tanvirbinzahid/Smart-Flood-Early-Warning-System-STM32/Simulation_Data/figures/ablation_study.png

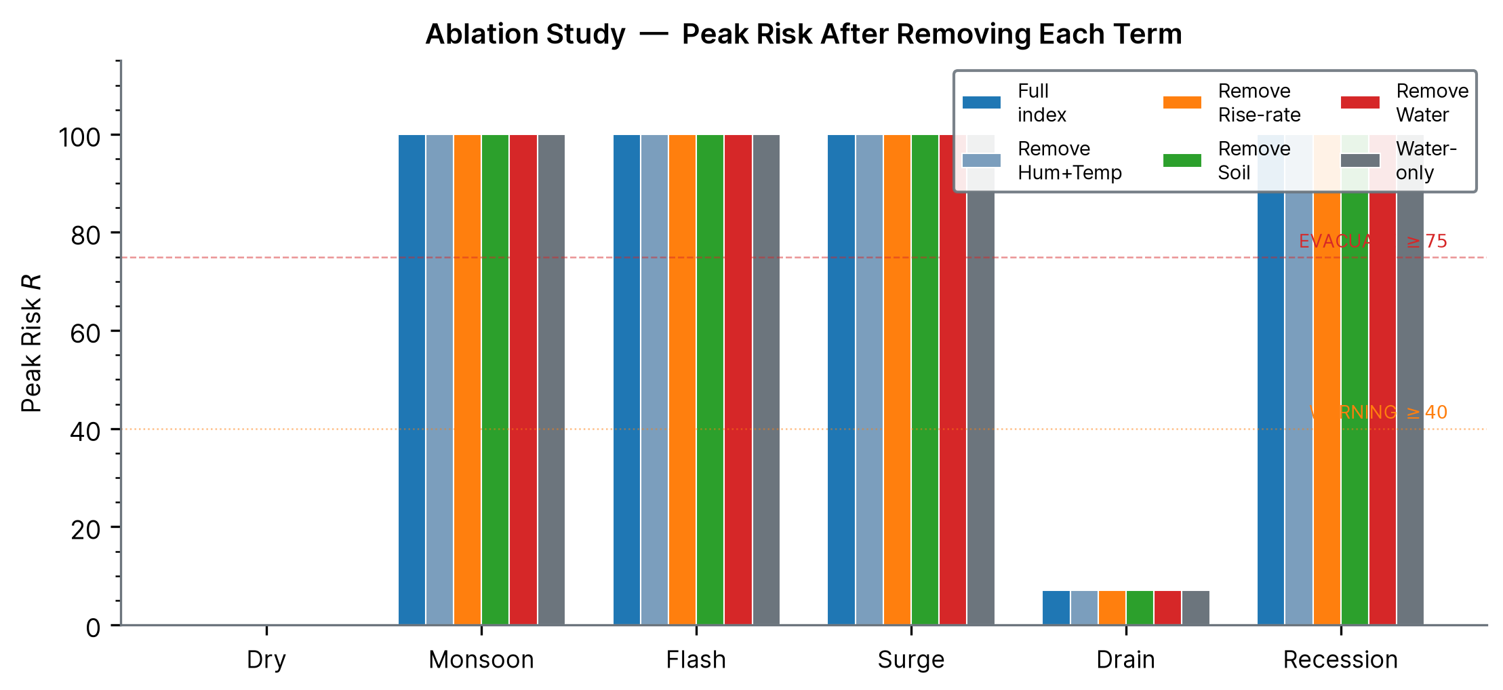
Simulation_Data/figures/ablation_study.png
