tanvirbinzahid/Smart-Flood-Early-Warning-System-STM32/Simulation_Data/figures/coastal_storm_surge.png

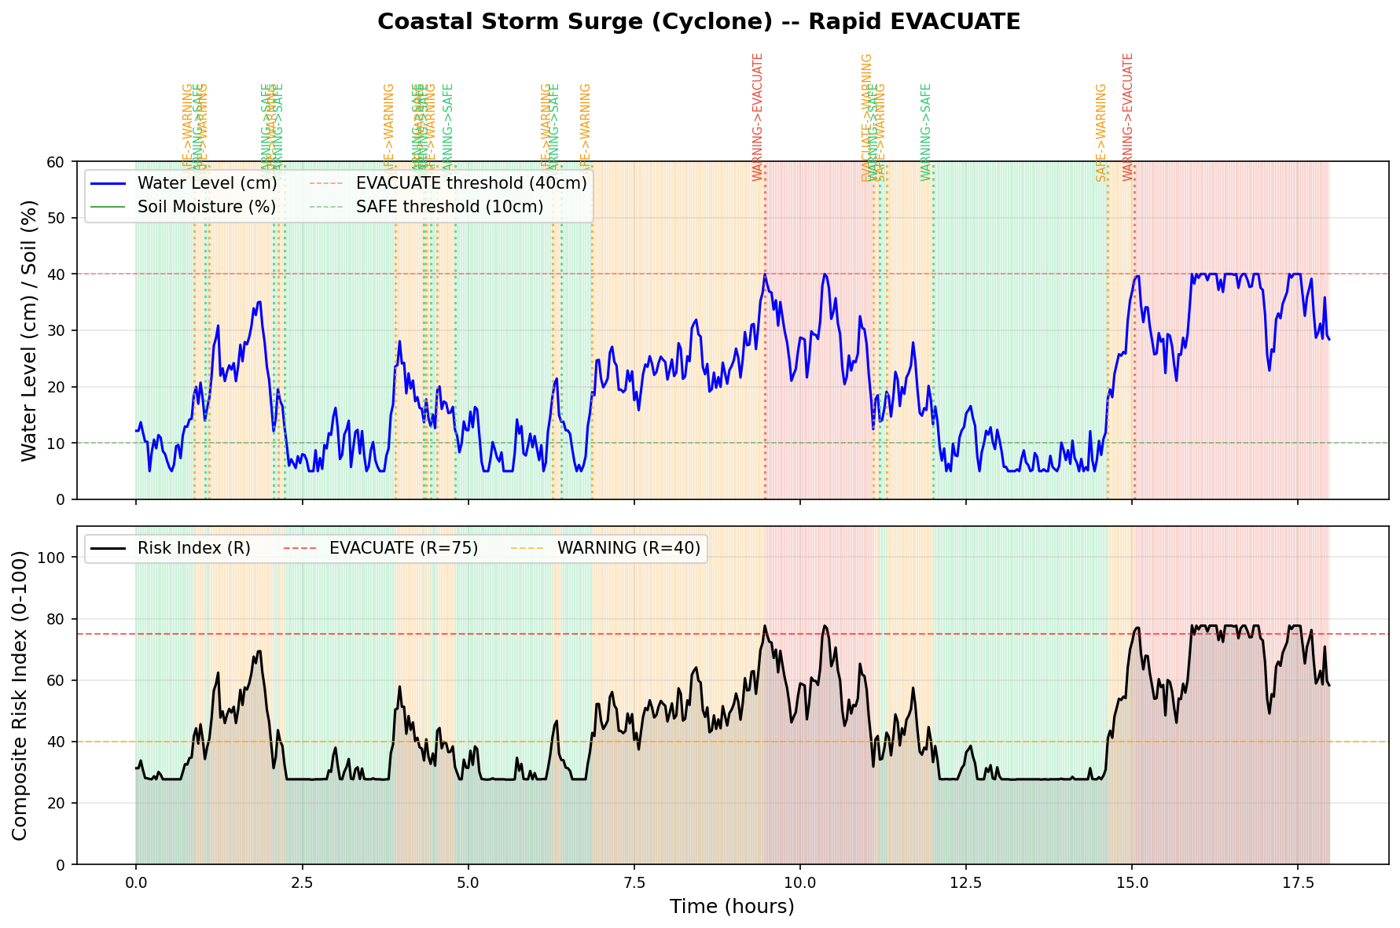
Simulation_Data/figures/coastal_storm_surge.png
