tanvirbinzahid/Smart-Flood-Early-Warning-System-STM32/Simulation_Data/figures/ffwc_buriganga_timeline.png

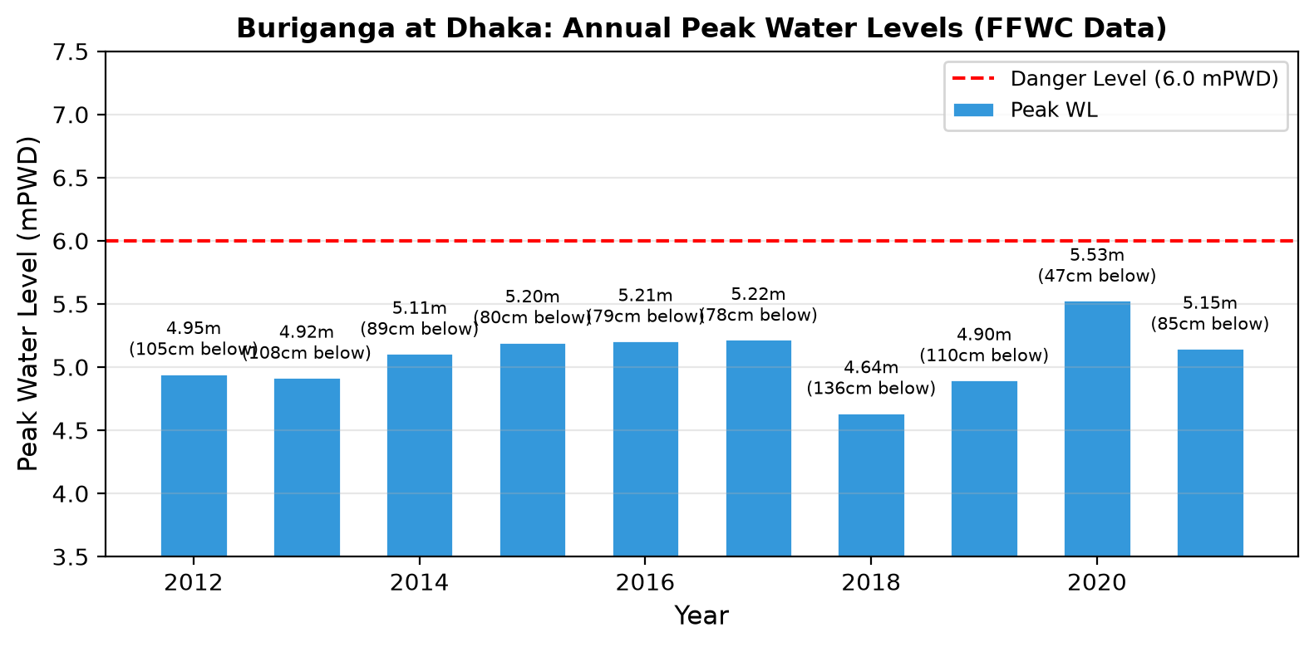
Simulation_Data/figures/ffwc_buriganga_timeline.png
