tanvirbinzahid/Smart-Flood-Early-Warning-System-STM32/Simulation_Data/figures/flash_flood.png

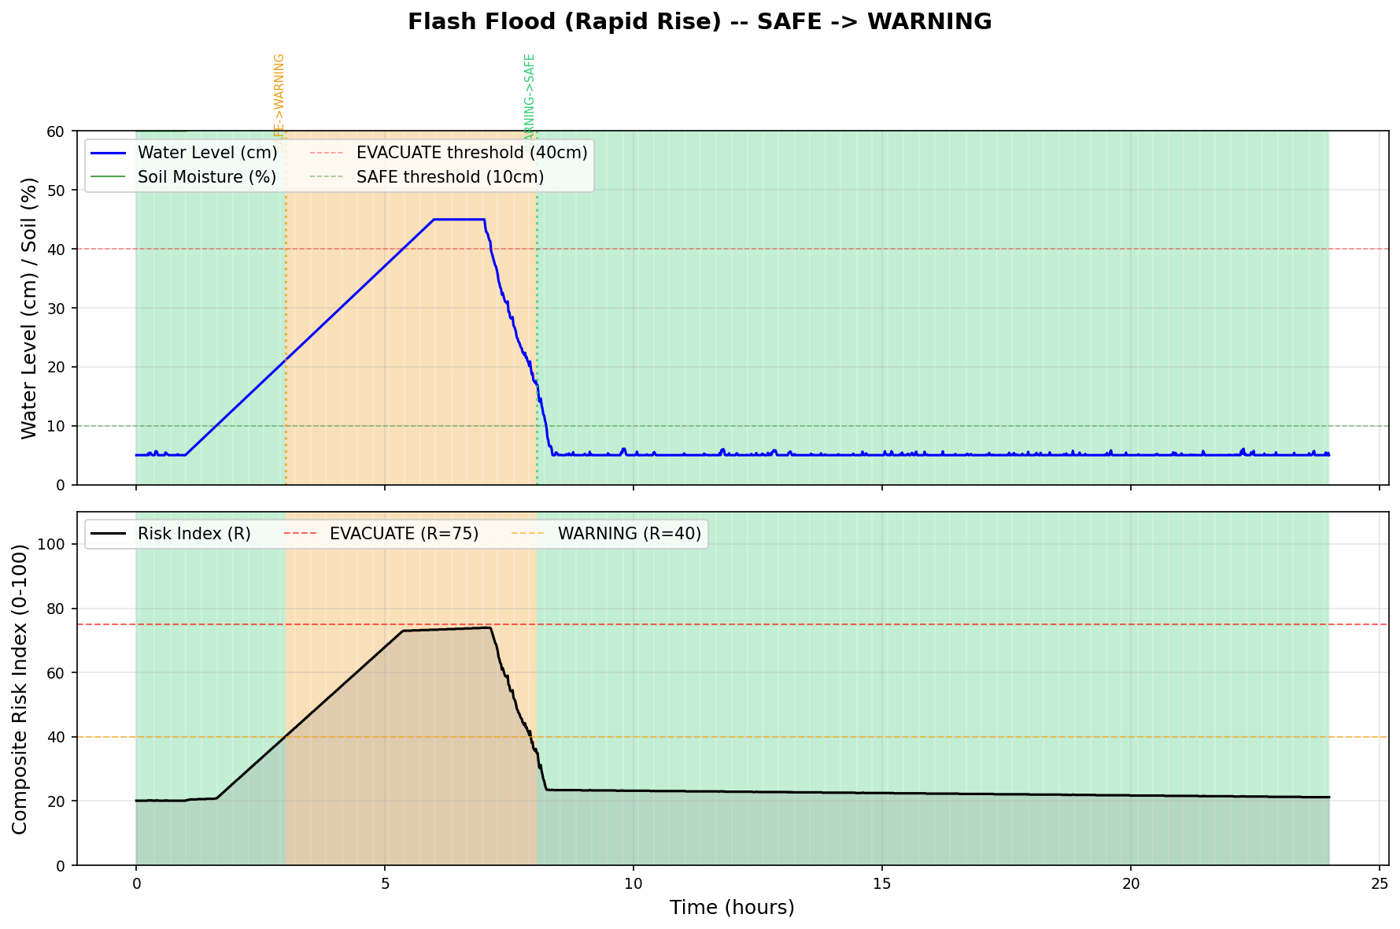
Simulation_Data/figures/flash_flood.png
