tanvirbinzahid/Smart-Flood-Early-Warning-System-STM32/Simulation_Data/figures/hw_accuracy_scatter.png

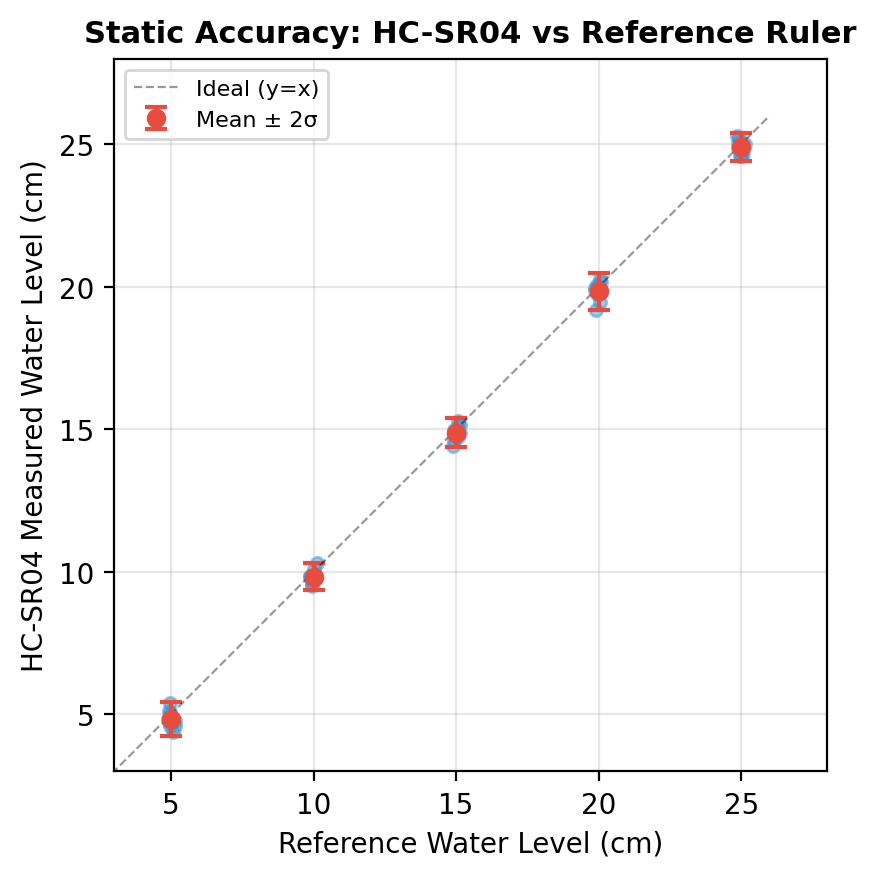
Simulation_Data/figures/hw_accuracy_scatter.png
