tanvirbinzahid/Smart-Flood-Early-Warning-System-STM32/Simulation_Data/figures/hw_bland_altman.png

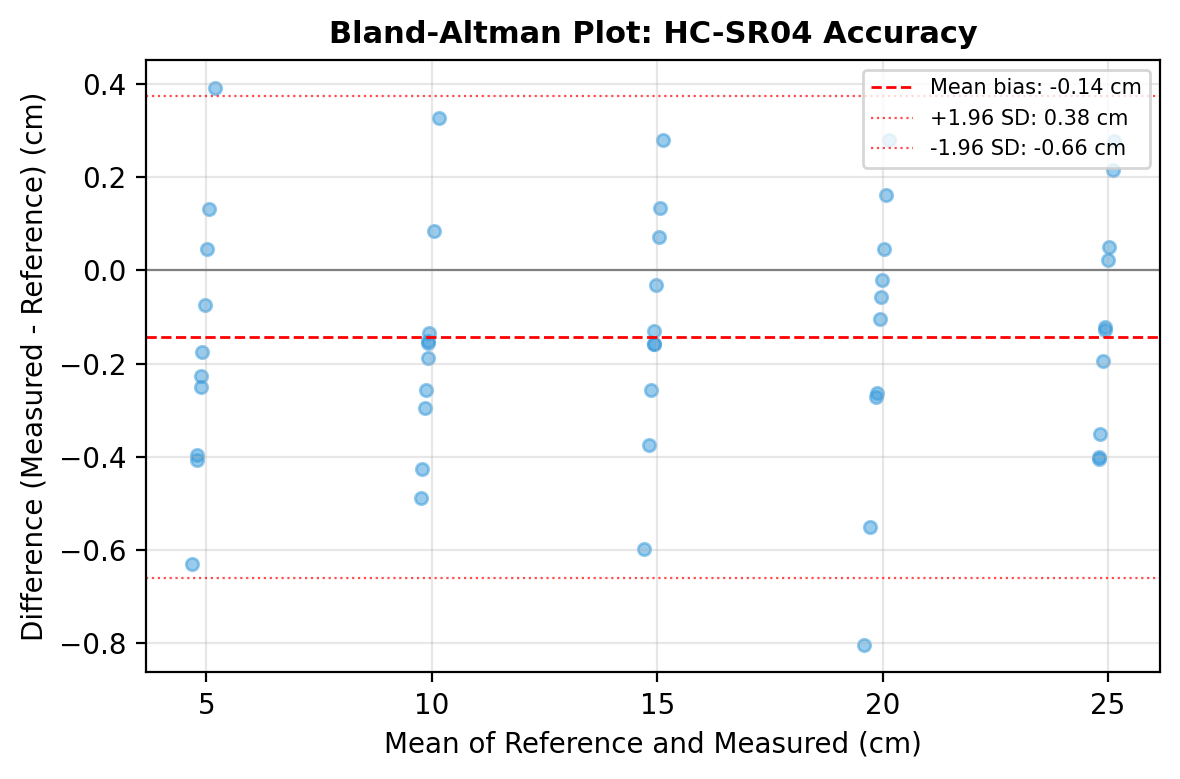
Simulation_Data/figures/hw_bland_altman.png
