tanvirbinzahid/Smart-Flood-Early-Warning-System-STM32/Simulation_Data/figures/monsoon_gradual.png

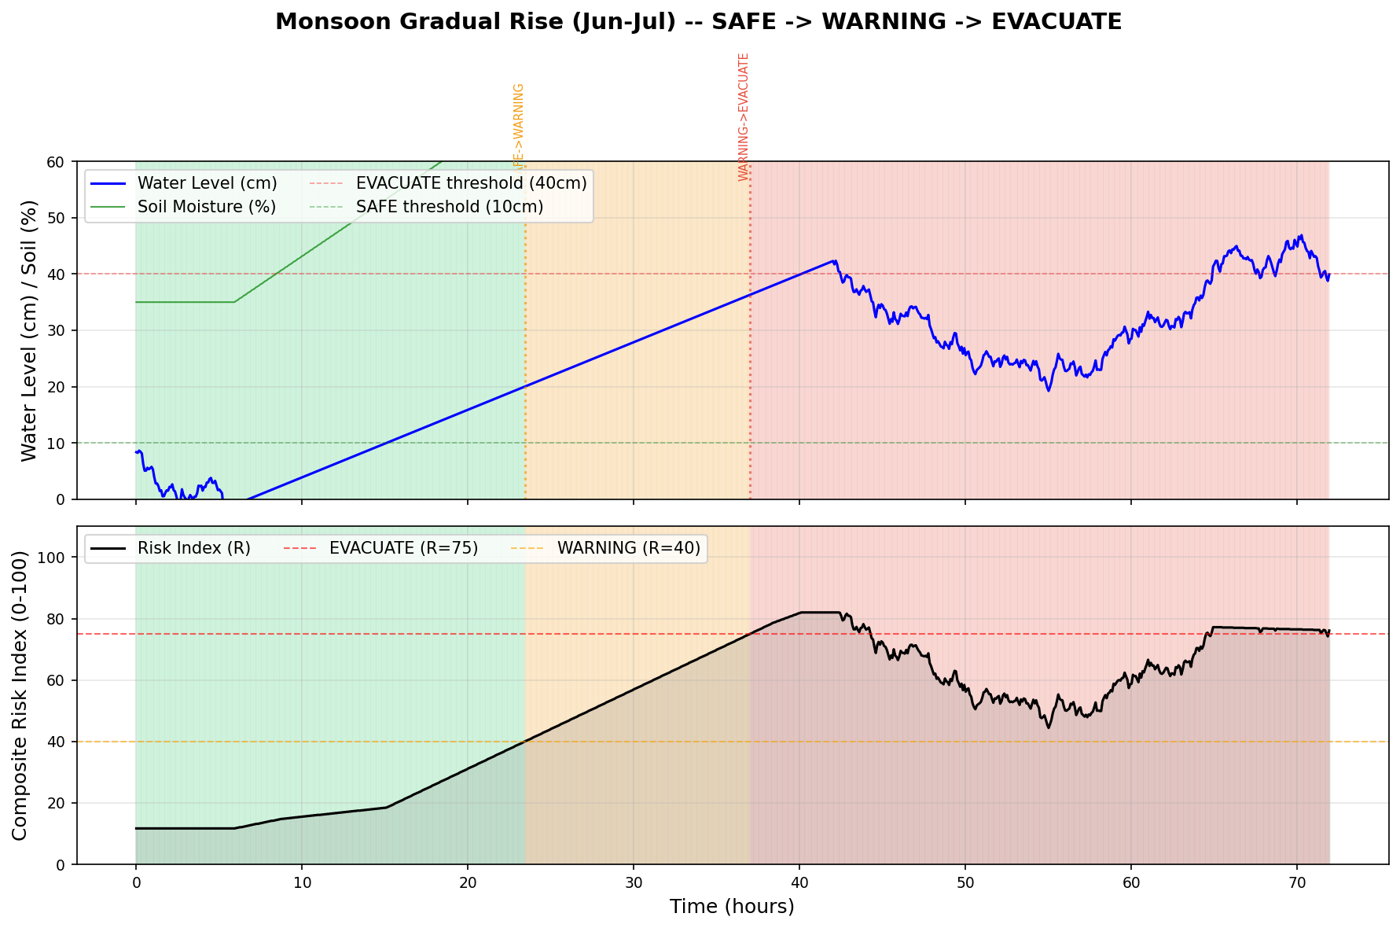
Simulation_Data/figures/monsoon_gradual.png
