tanvirbinzahid/Smart-Flood-Early-Warning-System-STM32/Simulation_Data/figures/normal_dry.png

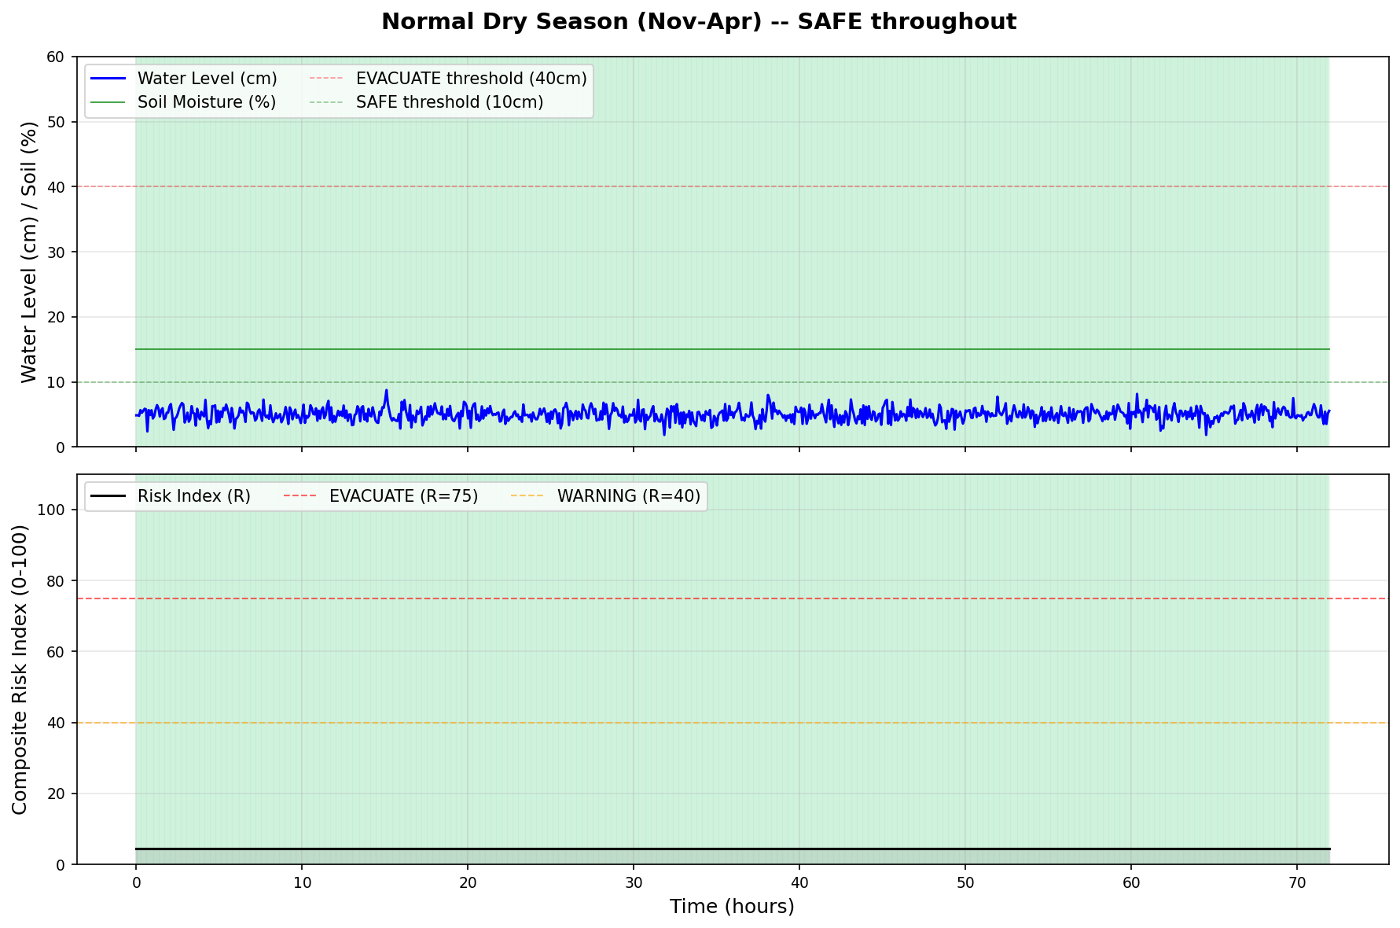
Simulation_Data/figures/normal_dry.png
