tanvirbinzahid/Smart-Flood-Early-Warning-System-STM32/Simulation_Data/figures/post_flood_recession.png

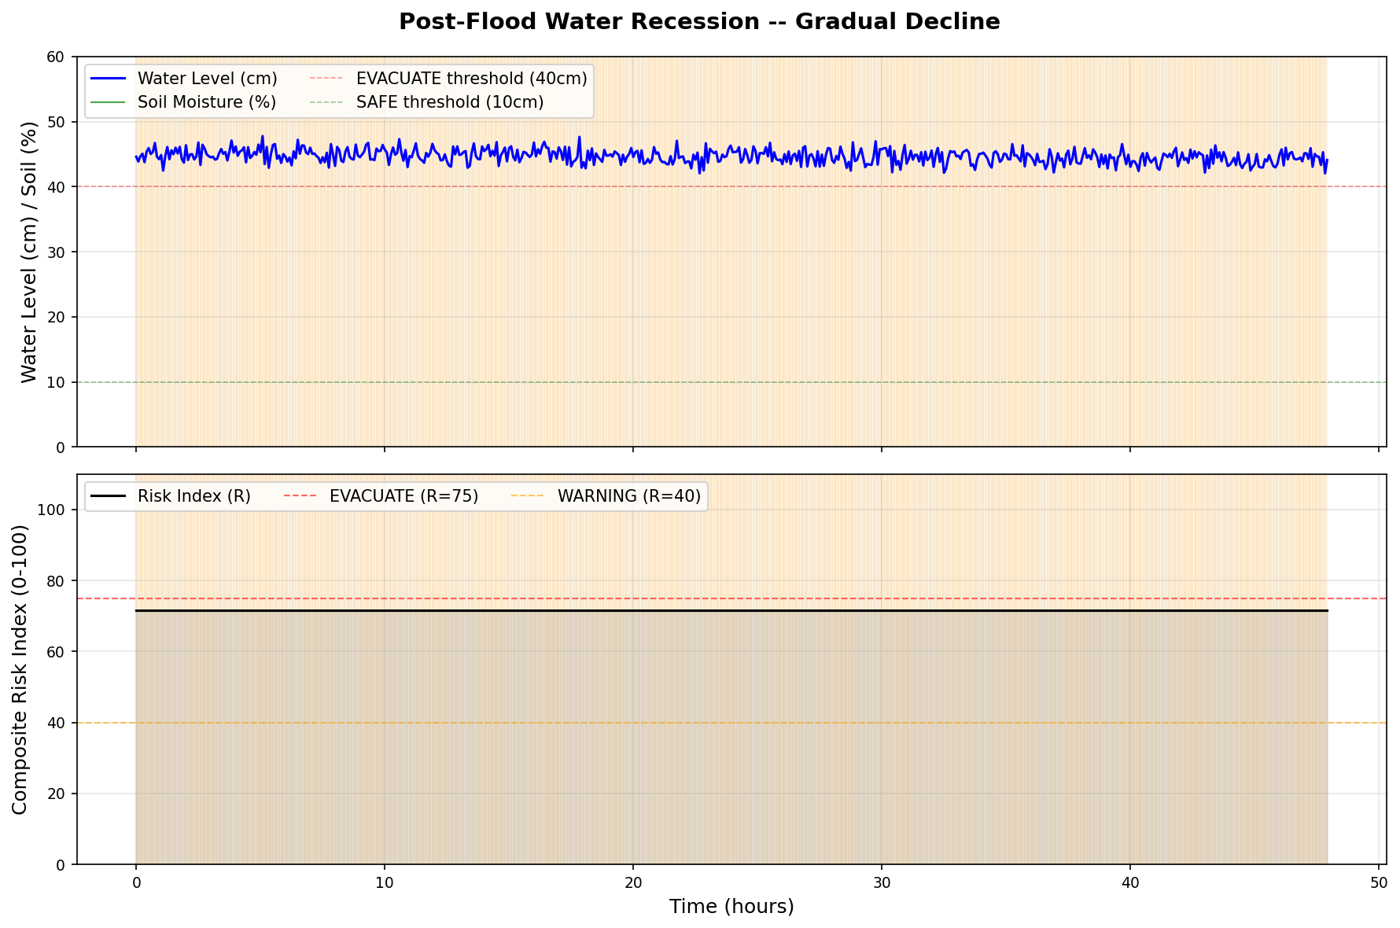
Simulation_Data/figures/post_flood_recession.png
