tanvirbinzahid/Smart-Flood-Early-Warning-System-STM32/Simulation_Data/figures/urban_drain_overload.png

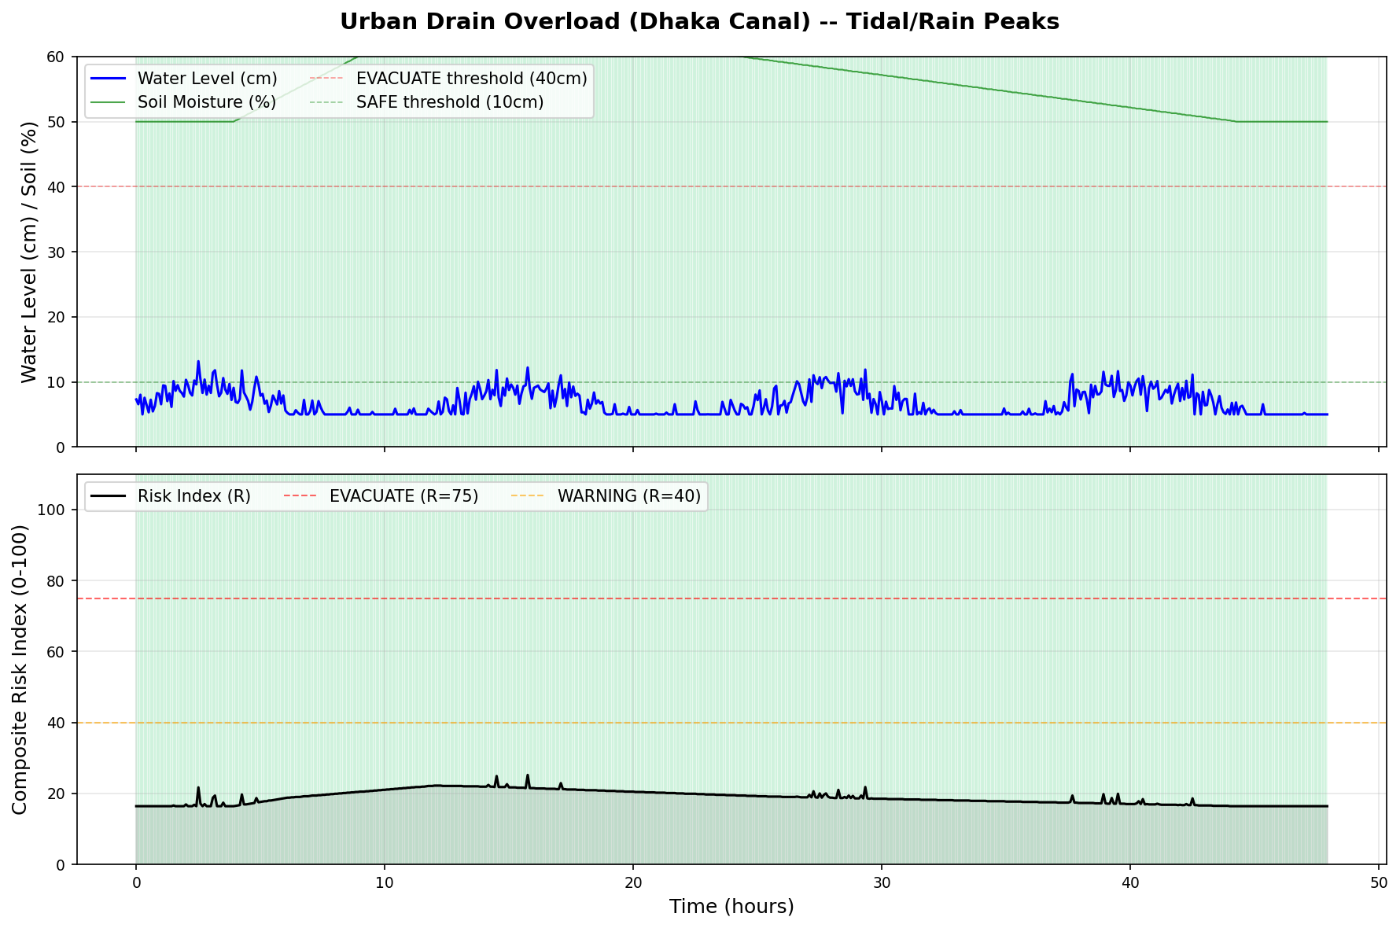
Simulation_Data/figures/urban_drain_overload.png
