tanvirbinzahid/Smart-Flood-Early-Warning-System-STM32/Simulation_Data/scripts/figures/all_scenarios_comparison.png

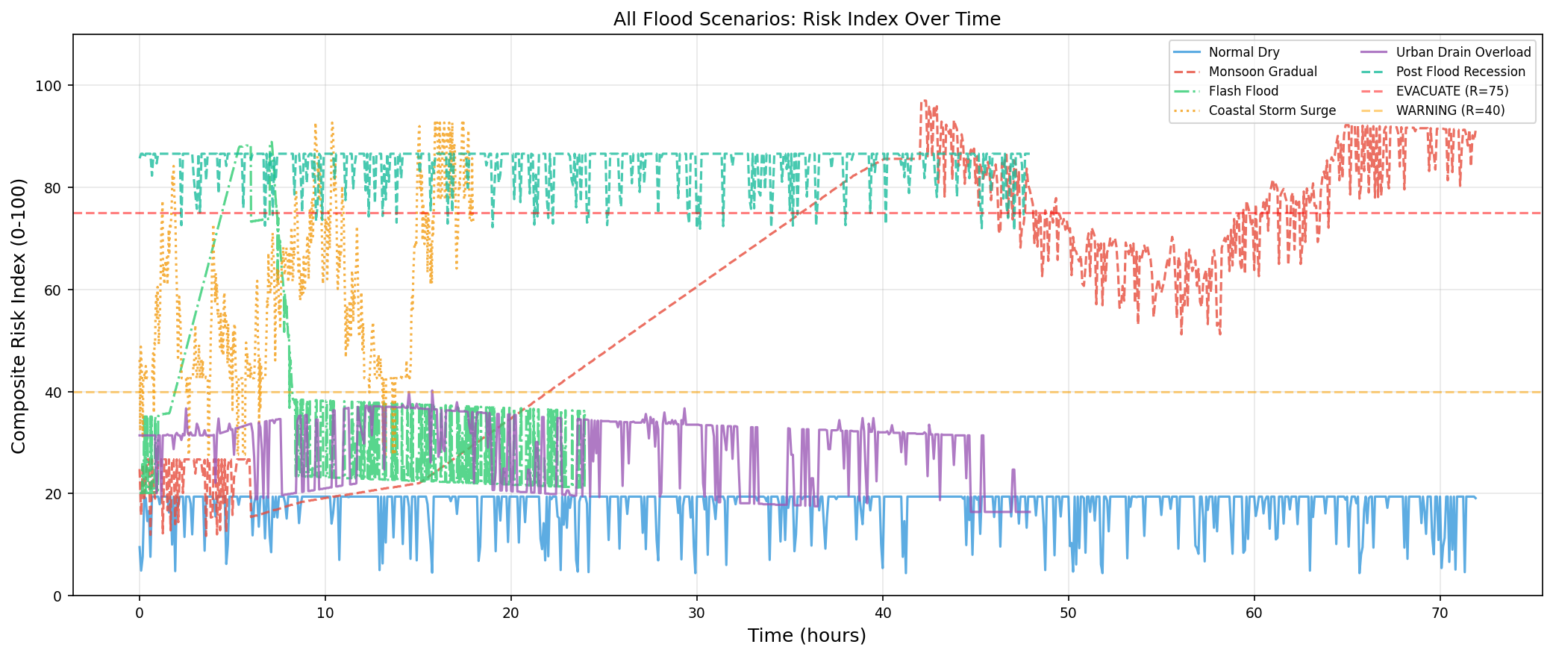
Simulation_Data/scripts/figures/all_scenarios_comparison.png
