tanvirbinzahid/Smart-Flood-Early-Warning-System-STM32/Simulation_Data/scripts/figures/coastal_storm_surge.png

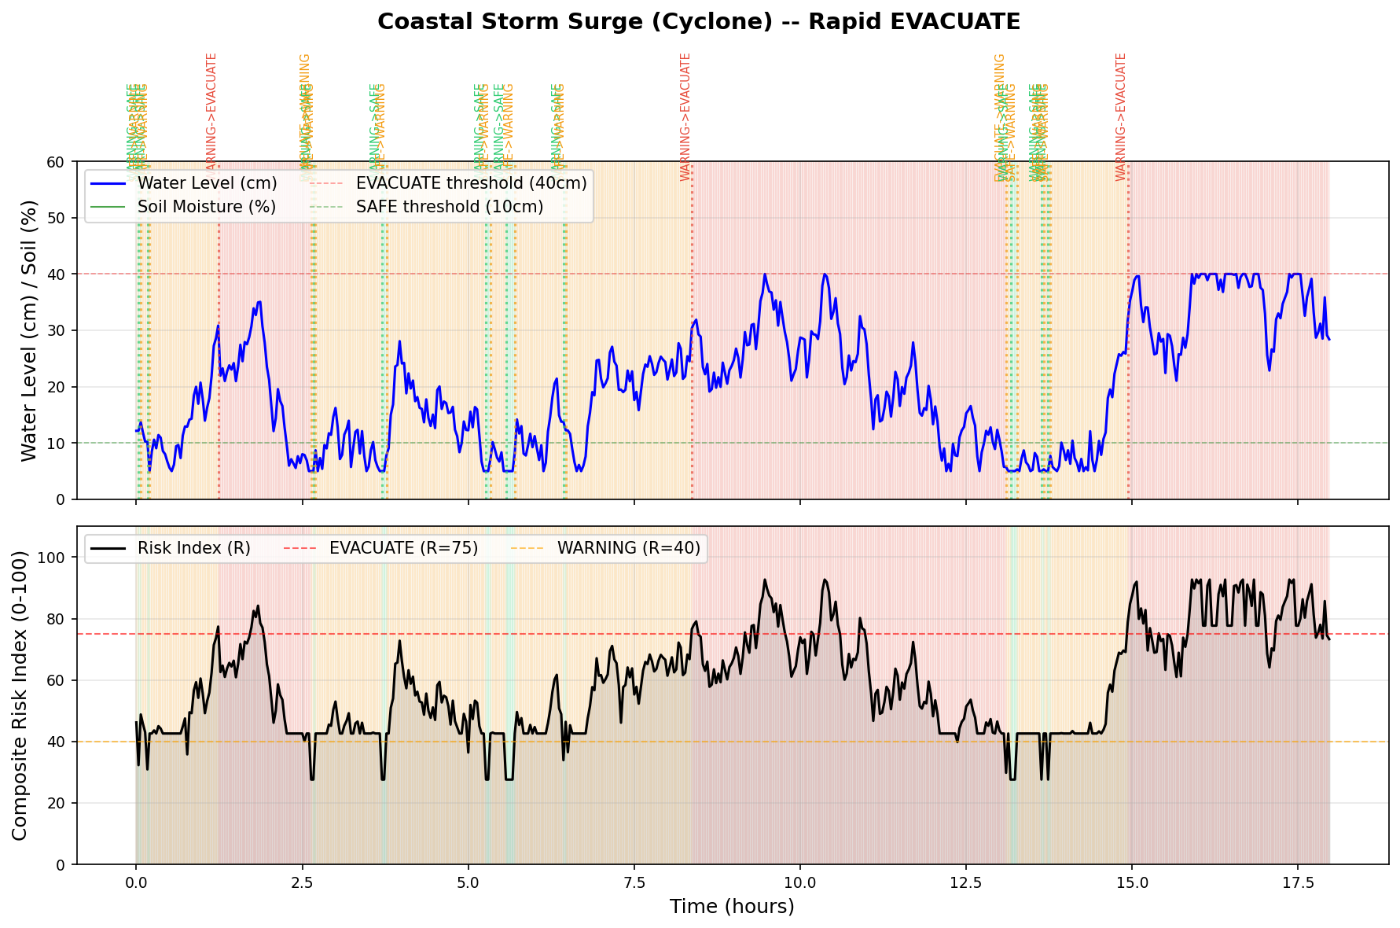
Simulation_Data/scripts/figures/coastal_storm_surge.png
