tanvirbinzahid/Smart-Flood-Early-Warning-System-STM32/Simulation_Data/scripts/figures/flash_flood.png

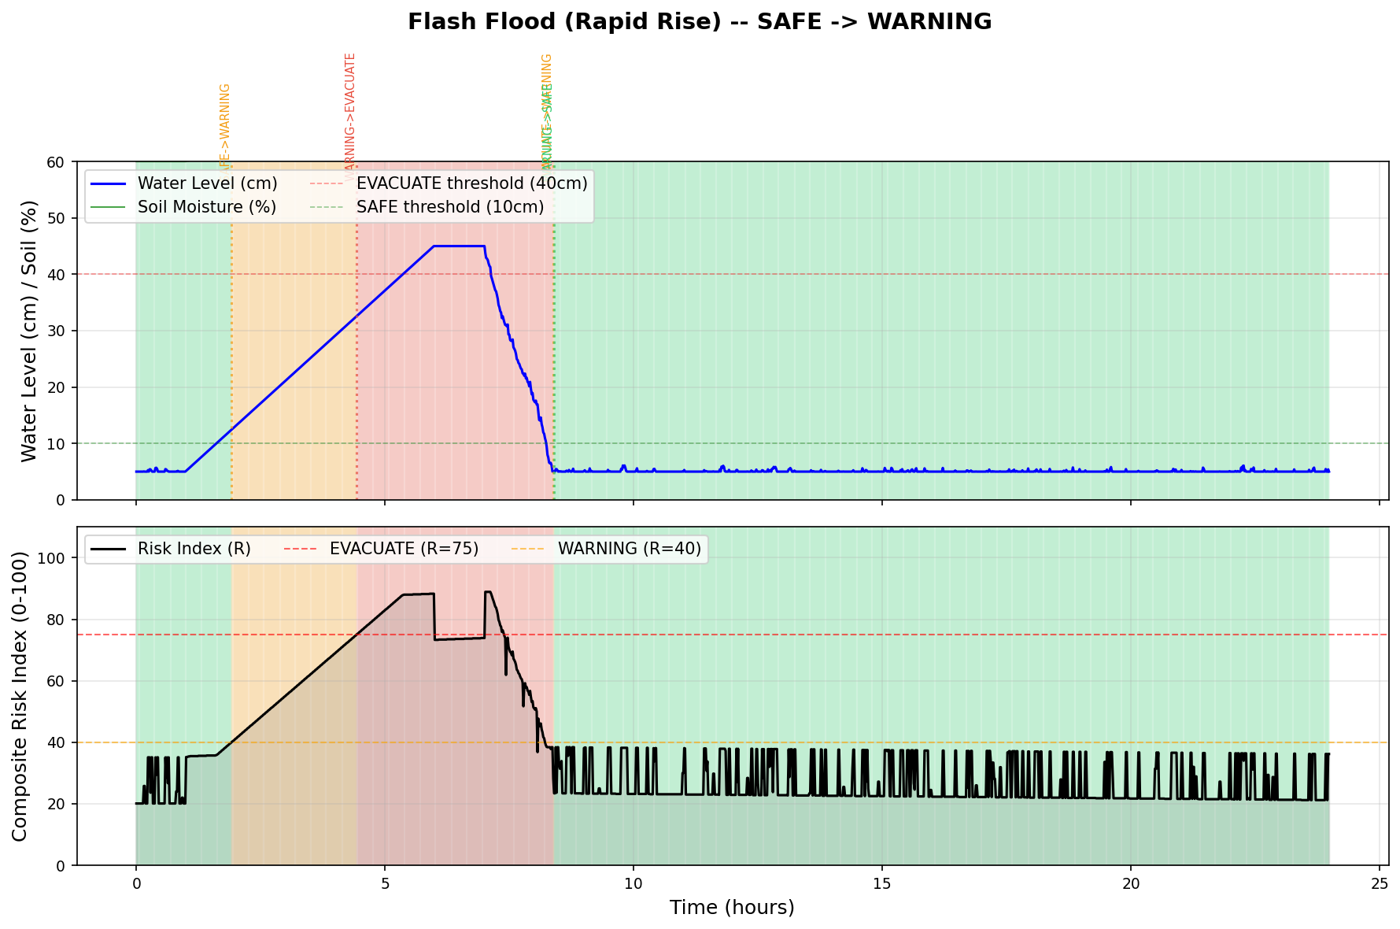
Simulation_Data/scripts/figures/flash_flood.png
