tanvirbinzahid/Smart-Flood-Early-Warning-System-STM32/Simulation_Data/scripts/figures/monsoon_gradual.png

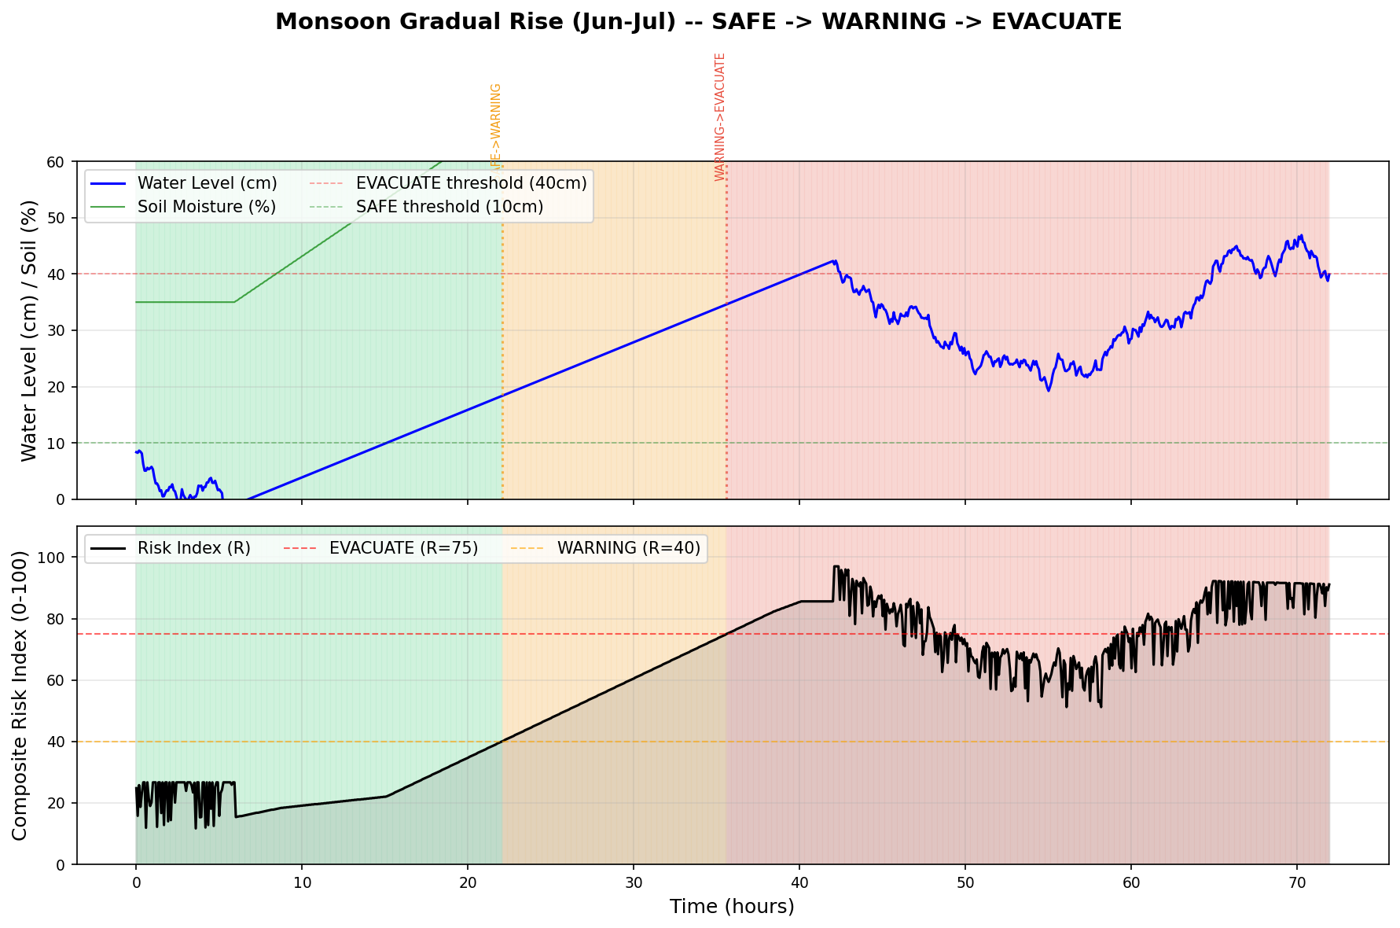
Simulation_Data/scripts/figures/monsoon_gradual.png
