tanvirbinzahid/Smart-Flood-Early-Warning-System-STM32/Simulation_Data/scripts/figures/normal_dry.png

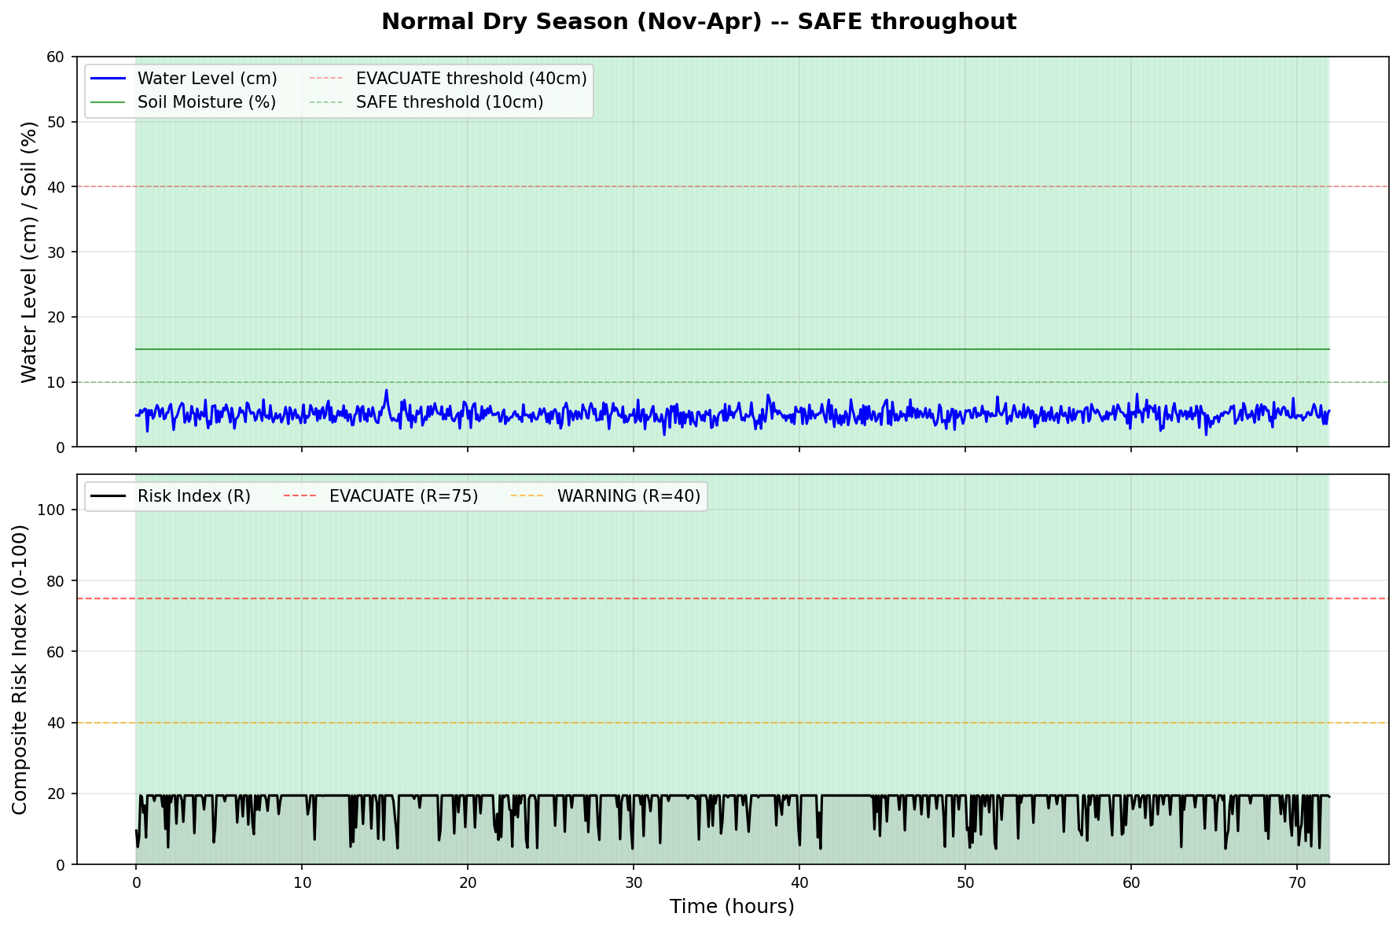
Simulation_Data/scripts/figures/normal_dry.png
