tanvirbinzahid/Smart-Flood-Early-Warning-System-STM32/Simulation_Data/scripts/figures/post_flood_recession.png

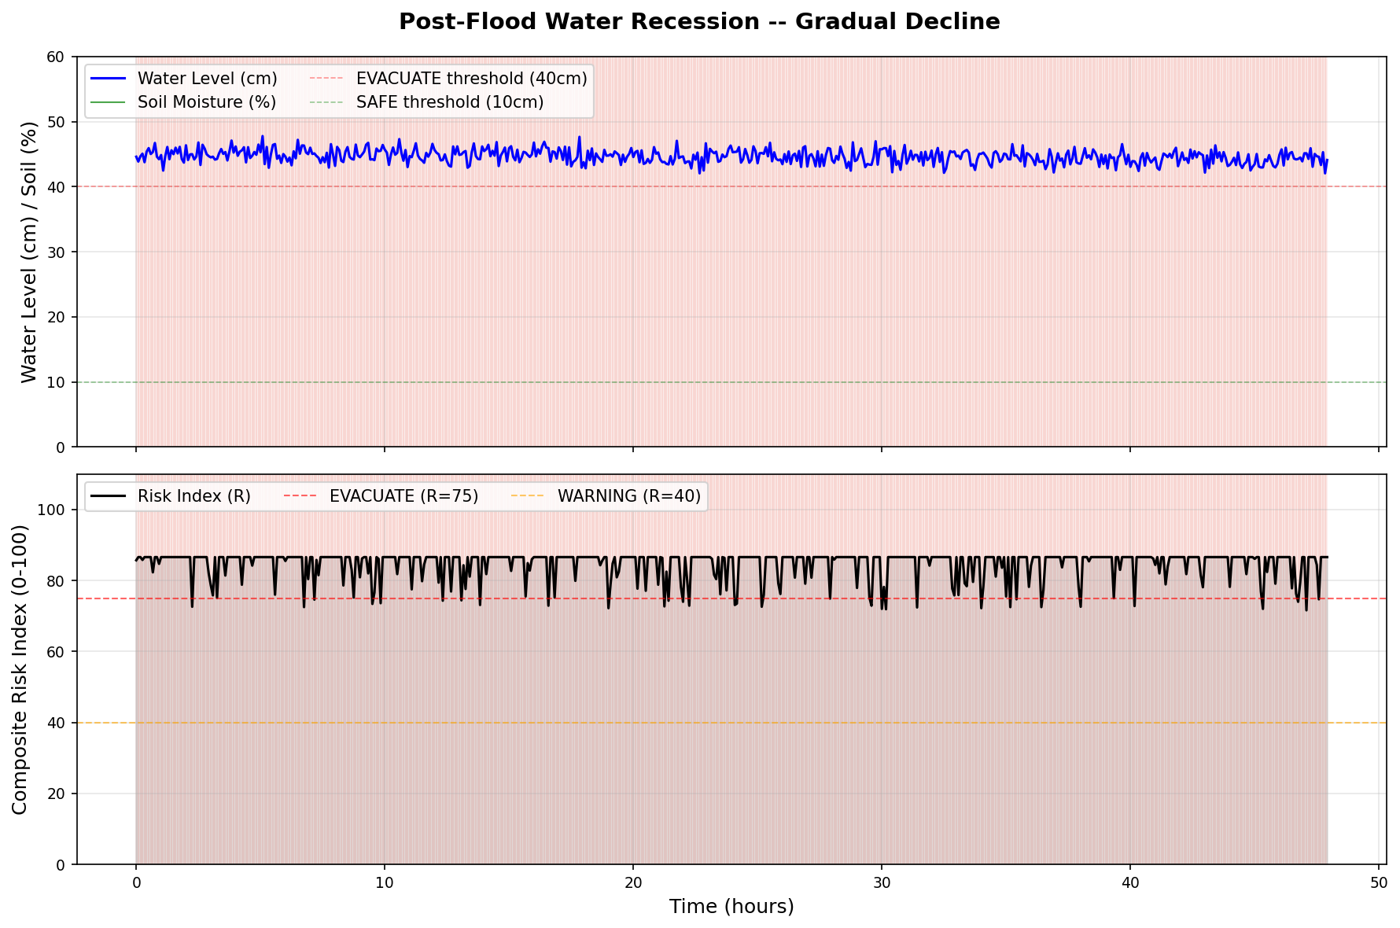
Simulation_Data/scripts/figures/post_flood_recession.png
