tanvirbinzahid/Smart-Flood-Early-Warning-System-STM32/Simulation_Data/datasets/hardware_dynamic_test.csv

reference_cm | measured_cm | error_cm
0 | 0.38 | 0.38
2 | 1.73 | -0.27
4 | 3.88 | -0.12
6 | 6.17 | 0.17
8 | 7.22 | -0.78
10 | 10.04 | 0.04
12 | 11.71 | -0.29
14 | 14.34 | 0.34
16 | 15.88 | -0.12
18 | 17.73 | -0.27
20 | 19.81 | -0.19
