tanvirbinzahid/Smart-Flood-Early-Warning-System-STM32/Simulation_Data/figures/evaluation_metrics.png

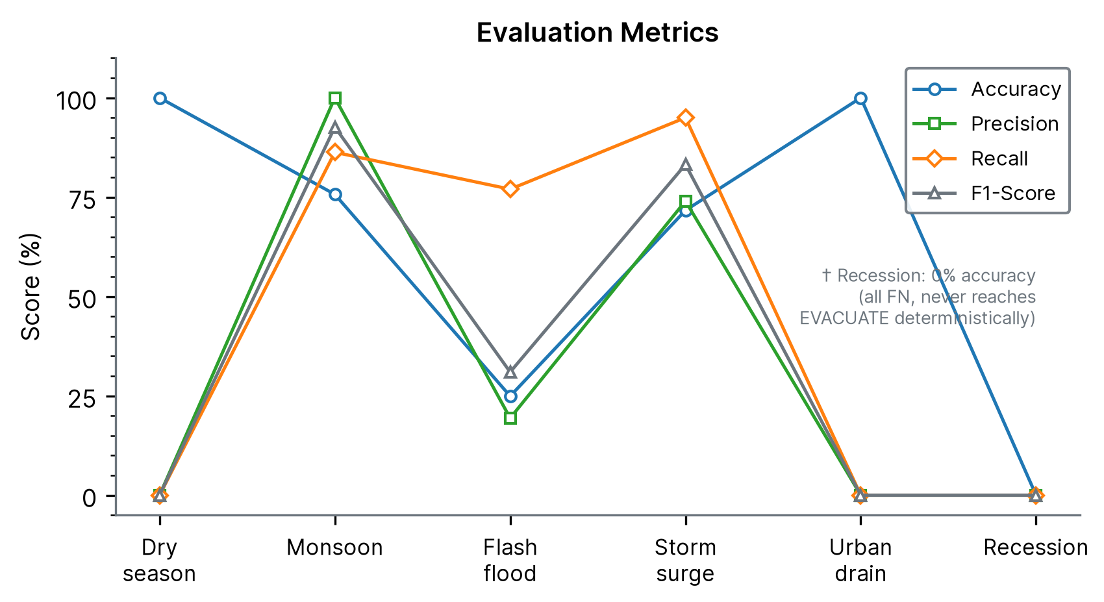
Simulation_Data/figures/evaluation_metrics.png
