tanvirbinzahid/Smart-Flood-Early-Warning-System-STM32/Simulation_Data/figures/ffwc_historical_risk_bars.png

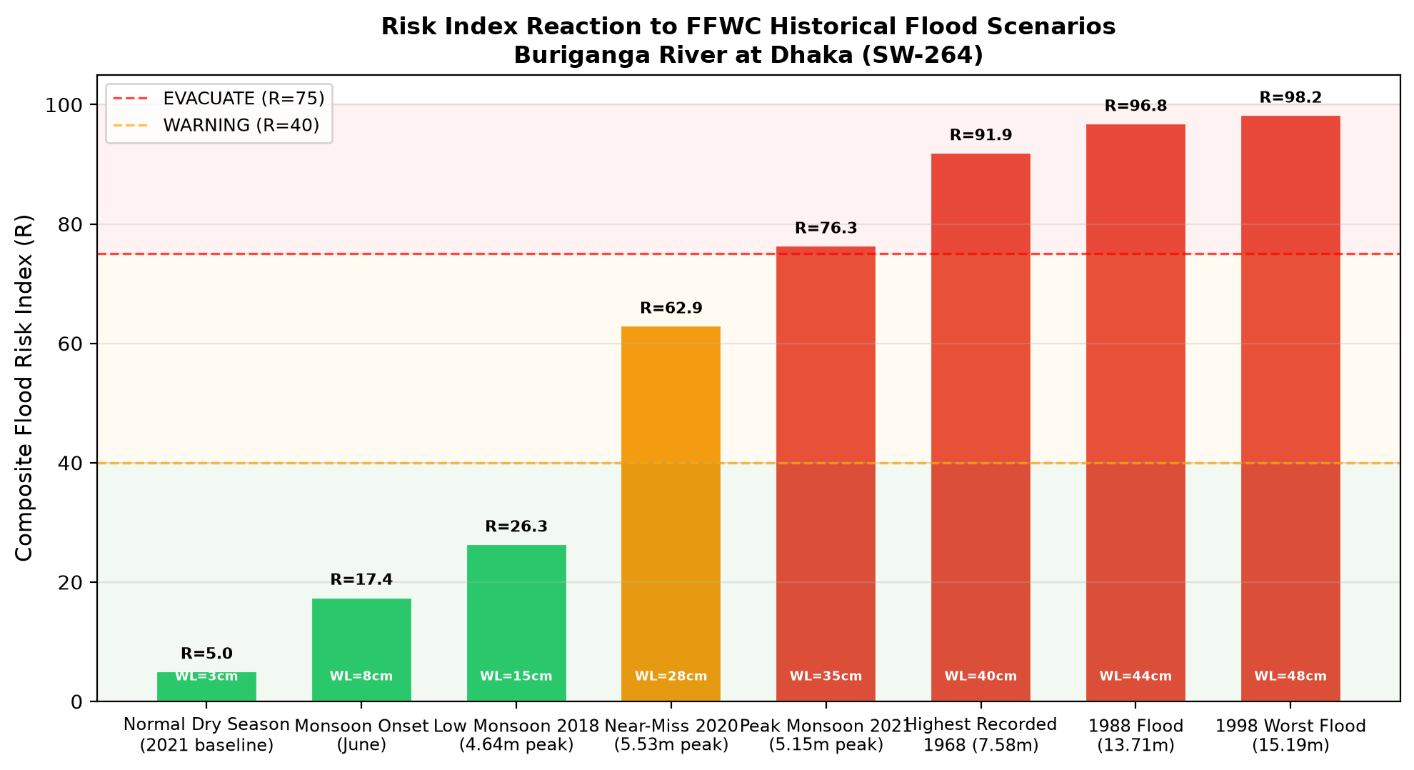
Simulation_Data/figures/ffwc_historical_risk_bars.png
