tanvirbinzahid/Smart-Flood-Early-Warning-System-STM32/Simulation_Data/figures/hw_risk_noise.png

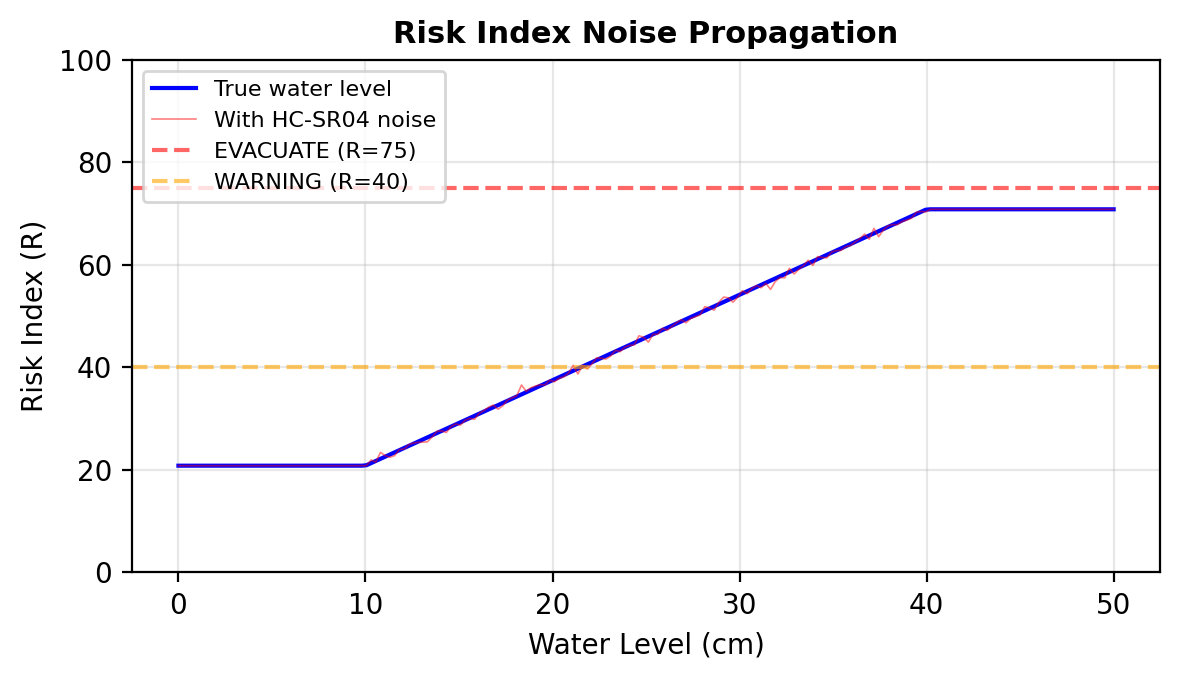
Simulation_Data/figures/hw_risk_noise.png
