tanvirbinzahid/Smart-Flood-Early-Warning-System-STM32/(commit log)

2026-06-01 Add breadboard circuit diagram image to README
2026-06-02 Update to final main.c: new 5-level LED bar, trend engine, ultra deadband/soil calibration tuning, OLED power-save at 40s, inverted water level display, updated risk weights; sync README with all new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
    [main.c]
2026-06-02 Remove Hardware Bill of Materials section from README
2026-06-02 Add pin configuration diagram to Hardware section
2026-07-15 Fix temperature-term bug (w_t*0 -> w_t*T): all D1-D4 numbers now reflect 5-term Eq (1)
2026-07-15 Run USGS + TerraClimate fetchers: 23,751 water level readings + 9 soil moisture values
    USGS data (real, free, anonymous):
    - Mississippi River 2011 (07374000): 8,705 readings
    - Hurricane Harvey 2017 (08068500): 1,246 readings
    - Midwest 2019 (06934500): 13,800 readings
    TerraClimate soil moisture (Abatzoglou 2018):
    - Mississippi 2011: 33% saturation (upstream-driven flood)
    - Harvey 2017: 100% saturation (local saturation)
    - Midwest 2019: 98-100% saturation (prolonged)
    Also fixed USGS URL to waterservices.usgs.gov (old endpoint still works;
    api.waterdata.usgs.gov returns 404)
    [Harvey_Houston_soil_moisture.csv, Hurricane_Harvey_2017.csv, Midwest_Floods_2019.csv, Midwest_Hermann_soil_moisture.csv, Mississippi_River_2011.csv, Mississippi_River_Baton_Rouge_soil_moisture.csv]
2026-07-15 Fix Vmax cm/s->cm/h bug in generate_ffwc_plots.py + consistent temp norm
    Bug: FFWC script converted rise rate cm/h->cm/s but kept V_MAX=5.0
    as if cm/h, making RR 3600x too small. Fixed by removing the /3600
    conversion (rise values are already in cm/h in the scenario data).
    Also fixed inconsistent temperature normalization across all scripts:
    piecewise thresholds (35/32/15 C) replaced with linear formula:
    T = clip(100 * (temp - 20) / 20, 0, 100) # 20 C -> 0, 40 C -> 100
    consistent with norm_temp() used in D1-D4 analysis scripts.
    Regenerated: ffwc_risk_components.png, ffwc_historical_risk_bars.png,
    ffwc_hypothetical_scenarios.csv (RR component now visible in figures)
    [ffwc_hypothetical_scenarios.csv]
